jakubprzybytek/MobilePowerSupply/KiCad/MobilePowerBank/MobilePowerBank.kicad_pcb

## KiCad design KiCad/MobilePowerBank/MobilePowerBank.kicad_pcb (2019-04-13)

Schematic: MobilePowerBank.sch

Parts:
C1, C5, C11, C28, C45, C46, C71: 47u/35V; CP_Tantalum_Case-D_EIA-7343-31_Reflow
C2, C29, C30, C47, C48, C72: 10u/50V/X7R; C_2220
C3: 4n7; C_0805
C4, C33, C34, C51, C52, C73, C74: 22n; C_0805
C6, C7, C8, C13, C15, C16, C18, C20, C26, C39, C40, C41, C42, C57, C58, C59, C60, C63, C65, C67, C69, C77, C78: 100n; C_0805
C9, C10, C35, C36, C37, C38, C53, C54, C55, C56: 47u/1-45mESR; CP_Tantalum_Case-D_EIA-7343-31_Reflow
C12: 220n; C_0805
C14: 47u/16V; CP_Tantalum_Case-C_EIA-6032-28_Reflow
C17: 47u/6.3V; CP_Tantalum_Case-C_EIA-6032-28_Reflow
C19, C21, C64, C66, C68, C70: 10u/6.3V; CP_Tantalum_Case-B_EIA-3528-21_Reflow
C22, C23: 10u/16V; CP_Tantalum_Case-B_EIA-3528-21_Reflow
C24, C25, C27, C43, C44, C61, C62, C79: 1u; C_0805
C31, C32: 10n; C_0805
C49, C50: 4u7; C_0805
C75: 330n / 50V; C_0805
C76: 22u/16V; CP_Elec_4x5.8
C80, C82, C83, C84, C85, C86: 1u/50V; C_1206
C81: 100u/6V3; C_1812
D1: LED; D_0805
F1: 5A; Fuseholder5x20_horiz_open_inline_Type-I
J1: Power IN; TerminalBlock_Altech_AK300-2_P5.00mm
J2: Power OUT 2; TerminalBlock_Altech_AK300-2_P5.00mm
J3: Power OUT 1; TerminalBlock_Altech_AK300-2_P5.00mm
J4: OLED I2C; OLED_0.96inch_128x64_I2C
J5: PDI; Pin_Header_Straight_2x03_Pitch2.54mm
J6: OLED; FPC_30
J7: Power OUT 3; TerminalBlock_Altech_AK300-2_P5.00mm
J8: Power OUT 4; TerminalBlock_Altech_AK300-2_P5.00mm
J9: Power OUT 5; TerminalBlock_Altech_AK300-2_P5.00mm
J10: Power OUT 6; TerminalBlock_Altech_AK300-2_P5.00mm
J11: PowerLED; JST_XH_B02B-XH-A_02x2.50mm_Straight
L1: 10u; L_1206
MH1, MH2, MH3, MH4: MountingHole_Pad; MountingHole_3.5mm
R1, R6, R87: 68k; R_0805
R2, R9, R10, R21, R38, R39, R66, R67: 2k2; R_0805
R3, R14, R16, R17, R18, R19, R48, R49, R50, R51, R52, R53, R76, R77, R78, R79, R80, R81, R94, R95, R96: 0R033; R_2512
R4, R15, R20, R36, R37, R54, R55, R64, R65, R82, R83, R97: 20k; R_0805
R5, R12, R86: 100k; R_0805
R7, R27, R33, R35, R61, R63: 300k; R_0805
R8, R11, R23, R24, R47, R73, R75, R93: 10k; R_0805
R13, R28: 4k7; R_0805
R22, R29, R31, R44, R57, R59: 47k; R_0805
R25: 1M; R_1206
R26, R30, R56, R58: 220k; R_0805
R32, R34, R60, R62: 30k; R_0805
R40, R41, R42, R43, R68, R69, R70, R71: 15k4; R_0805
R45: 3k9; R_0805
R46, R72, R74, R92: 90k; R_0805
R84, R85, R98: 0; R_0805
R88: 11k; R_0805
R89: 1k5; R_0805
R90: 7k68; R_0805
R91: 200; R_0805
R99: 3k3; R_0805
SW1: SW_DIP_x01; Pin_Header_Angled_1x02_Pitch2.54mm
U1, U4, U9, U10, U13, U14, U16: INA139; SOT-23-5
U2, U7, U8: LMZ14203H; TO-263-7_TabPin4
U3: L78M12; TO-252-2_Rectifier
U5: UA78M33; TO-252-2_Rectifier
U6: LMZ14203; TO-263-7_TabPin4
U11, U12: LMZ14201H; TO-263-7_TabPin4
U15: ATXMEGA256A3U-AU; TQFP-64_14x14mm_Pitch0.8mm
U17: L78L05_SOT89; SOT-89-3
x1, x2, x3, x4, x6, x7, x8: jumper; Jumper_33x1.5
x5, x9: jumper; Jumper_45x1.5

Connections:
+3V3: C16.1, C17.1, C18.1, C19.1, C24.1, C63.1, C64.1, C65.1, C66.1, C67.1, C68.1, C69.1, C70.1, D1.2, J4.1, J5.2, J6.19, J6.20, J6.21, L1.1, R9.2, R10.2, R23.2, R24.1, U5.3 (OUT), U15.15 (VCC), U15.25 (VCC), U15.35 (VCC), U15.45 (VCC), U15.53 (VCC)
/+3.3VA: C20.1, C21.1, L1.2, U15.61 (AVCC)
/OLED_!DS: J6.17, U15.28 (RXD0/OC0C/PD2)
/OLED_!RES: J6.16, U15.31 (PD5/OC1B/XCK1/MOSI)
/OLED_D0: J6.12, U15.36 (PE0/OC0A/SDA/SDAIN)
/OLED_D1: J6.11, U15.37 (PE1/OC0B/XCK0/SCL/SCLIN)
/OLED_D2: J6.10, U15.38 (PE2/OC0C/RXD0/SDAOUT)
/OLED_D3: J6.9, U15.39 (PE3/OC0D/TXD0/SCLOUT)
/OLED_D4: J6.8, U15.40 (PE4/OC1A/~SS~)
/OLED_D5: J6.7, U15.41 (PE5/OC1B/XCK1/MOSI)
/OLED_D6: J6.6, U15.42 (PE6/RXD1/MISO/TOSC2)
/OLED_D7: J6.5, U15.43 (PE7/TXD1/SCK/TOSC1)
/OLED_D/!C: J6.15, U15.29 (TXD0/OC0D/PD3)
/OLED_E/!RD: J6.13, U15.30 (PD4/OC1A/~SS~)
/OLED_R/!W: J6.14, U15.32 (PD6/RXD1/D-/MISO)
GND: C5.2, C6.2, C12.2, C13.2, C14.2, C15.2, C16.2, C17.2, C18.2, C19.2, C20.2, C21.2, C22.2, C23.2, C24.2, C25.2, C26.2, C27.2, C39.2, C40.2, C43.2, C44.2, C57.2, C58.2, C61.2, C62.2, C63.2, C64.2, C65.2, C66.2, C67.2, C68.2, C69.2, C70.2, C77.2, C79.2, J4.2, J5.6, J6.1, J6.29, R25.1, R98.1, SW1.1, U3.2 (GND), U5.2 (GND), U15.14 (GND), U15.24 (GND), U15.34 (GND), U15.44 (GND), U15.52 (GND), U15.60 (GND)
GNDA: C1.2, C2.2, C3.2, C7.1, C8.1, C9.2, C10.2, C11.2, C28.2, C29.2, C30.2, C31.2, C32.2, C35.2, C36.2, C37.2, C38.2, C41.1, C42.1, C45.2, C46.2, C47.2, C48.2, C49.2, C50.2, C53.2, C54.2, C55.2, C56.2, C59.1, C60.1, C71.2, C72.2, C73.2, C75.2, C76.2, C78.1, C80.2, C81.2, C82.2, C83.1, C84.2, C85.2, C86.2, J1.1, J2.2, J3.2, J7.2, J8.2, J9.2, J10.2, J11.2, R2.2, R4.2, R13.2, R15.2, R20.2, R21.2, R36.2, R37.2, R38.2, R39.2, R45.2, R47.2, R54.2, R55.2, R64.2, R65.2, R66.2, R67.2, R73.2, R75.2, R82.2, R83.2, R88.2, R89.2, R93.2, R97.2, R98.2, U1.2, U2.4, U4.2, U6.4, U7.4, U8.4, U9.2, U10.2, U11.4, U12.4, U13.2, U14.2, U16.2, x6.1 (A), x6.2 (B), x7.1 (A), x7.2 (B), x8.1 (A), x8.2 (B), x9.1 (A), x9.2 (B)
IN_Current: C25.1, R4.1, U1.1, U15.11 (TDI/AC5/ADC5/PB5)
IN_Voltage: C15.1, R1.2, R2.1, U15.12 (TCK/AC1OUT/AC6/ADC6/PB6)
LED: R8.1, U15.48 (PF2/OC0C/RXD0)
unnamed: C3.1, U2.5
unnamed: C4.2, R21.1, R22.1, U2.6
unnamed: C5.1, C6.1, U3.1 (IN), x5.2 (B)
unnamed: C4.1, C8.2, C9.1, C10.1, C83.2, R14.2, R18.2, R19.2, R28.2, U2.7, U4.3, U4.5
unnamed: C23.1, J6.3
unnamed: C31.1, U7.5
unnamed: C32.1, U8.5
unnamed: C33.1, C35.1, C37.1, C41.2, C84.1, R42.2, R48.2, R49.2, R50.2, U7.7, U9.3, U9.5
unnamed: C33.2, R38.1, R40.1, U7.6
unnamed: C34.1, C36.1, C38.1, C42.2, C82.1, R43.2, R51.2, R52.2, R53.2, U8.7, U10.3, U10.5
unnamed: C34.2, R39.1, R41.1, U8.6
unnamed: C49.1, U11.5
unnamed: C50.1, U12.5
unnamed: C51.1, C53.1, C55.1, C59.2, C85.1, R70.2, R76.2, R77.2, R78.2, U11.7, U13.3, U13.5
unnamed: C51.2, R66.1, R68.1, U11.6
unnamed: C52.1, C54.1, C56.1, C60.2, C86.1, R71.2, R79.2, R80.2, R81.2, U12.7, U14.3, U14.5
unnamed: C52.2, R67.1, R69.1, U12.6
unnamed: C73.1, U6.5
unnamed: C74.1, C78.2, C80.1, C81.1, R91.2, R94.2, R95.2, R96.2, U6.7, U16.3, U16.5
unnamed: C74.2, R89.1, R90.1, U6.6
unnamed: C76.1, J11.1, R99.1, U17.2 (GND)
unnamed: D1.1, R8.2
unnamed: J6.4, R25.2
unnamed: R5.2, U2.2
unnamed: R6.2, R7.1
unnamed: R11.2, R23.1, SW1.2
unnamed: R7.2, R20.1, U2.3
unnamed: R22.2, R28.1
unnamed: R26.2, R32.1
unnamed: R5.1, R27.2
unnamed: R29.2, R33.1
unnamed: R30.2, R34.1
unnamed: R31.2, R35.1
unnamed: R32.2, U7.2
unnamed: R33.2, R36.1, U7.3
unnamed: R34.2, U8.2
unnamed: R35.2, R37.1, U8.3
unnamed: R40.2, R42.1
unnamed: R41.2, R43.1
unnamed: R56.2, R60.1
unnamed: R57.2, R61.1
unnamed: R58.2, R62.1
unnamed: R59.2, R63.1
unnamed: R60.2, U11.2
unnamed: R61.2, R64.1, U11.3
unnamed: R62.2, U12.2
unnamed: R63.2, R65.1, U12.3
unnamed: R68.2, R70.1
unnamed: R69.2, R71.1
unnamed: R84.2, R86.1
unnamed: R85.2, R87.1
unnamed: R86.2, U6.2
unnamed: R87.2, R88.1, U6.3
unnamed: R90.2, R91.1
unnamed: R99.2, U17.1 (OUT)
OUT_1_Current: C27.1, R15.1, U4.1, U15.3 (AC5/ADC5/PA5)
OUT_1_Voltage: C26.1, R12.2, R13.1, U15.4 (AC1OUT/AC6/ADC6/PA6)
OUT_2_Current: C43.1, R54.1, U9.1, U15.1 (AC3/ADC3/PA3)
OUT_2_Voltage: C39.1, R44.2, R45.1, U15.2 (AC4/ADC4/PA4)
OUT_3_Current: C44.1, R55.1, U10.1, U15.63 (AC1/ADC1/PA1)
OUT_3_Voltage: C40.1, R46.2, R47.1, U15.64 (AC2/ADC2/PA2)
OUT_4_Current: C61.1, R82.1, U13.1, U15.7 (AC1/ADC1/PB1)
OUT_4_Voltage: C57.1, R72.2, R73.1, U15.8 (DAC0/AC2/ADC2/PB2)
OUT_5_Current: C62.1, R83.1, U14.1, U15.5 (AC0OUT/AC7/ADC7/PA7)
OUT_5_Voltage: C58.1, R74.2, R75.1, U15.6 (AREFB/AC0/ADC0/PB0)
OUT_6_Current: C79.1, R97.1, U15.9 (DAC1/AC3/ADC3/PB3), U16.1
OUT_6_Voltage: C77.1, R92.2, R93.1, U15.10 (TMS/AC4/ADC4/PB4)
PDI_CLK: J5.5, R24.2, U15.57 (~RESET~/PDI_CLK)
PDI_DATA: J5.1, U15.56 (PDI_DATA)
POWER_1_OUT: J3.1, R12.1, R14.1, R18.1, R19.1, U4.4
POWER_2_OUT: J2.1, R44.1, R48.1, R49.1, R50.1, U9.4
POWER_3_OUT: J7.1, R46.1, R51.1, R52.1, R53.1, U10.4
POWER_4_OUT: J8.1, R72.1, R76.1, R77.1, R78.1, U13.4
POWER_5_OUT: J9.1, R74.1, R79.1, R80.1, R81.1, U14.4
POWER_6_OUT: J10.1, R92.1, R94.1, R95.1, R96.1, U16.4
POWER_IN: C11.1, C29.1, R3.1, R16.1, R17.1, R26.1, R29.1, U1.4, U7.1, x1.1 (A), x2.1 (A)
POWER_IN_1: C1.1, C2.1, R6.1, R27.1, U2.1, x2.2 (B), x3.1 (A)
POWER_IN_3: C28.1, C30.1, R30.1, R31.1, U8.1, x1.2 (B)
POWER_IN_4: C45.1, C46.1, C47.1, C48.1, R56.1, R57.1, R58.1, R59.1, U11.1, U12.1, x3.2 (B), x4.1 (A)
POWER_IN_6: C71.1, C72.1, R84.1, R85.1, U6.1, x4.2 (B), x5.1 (A)
SCK: J4.3, R9.1, U15.17 (SCLIN/SCL/XCK0/OC0AHS/OC0B/PC1)
SDA: J4.4, R10.1, U15.16 (SDAIN/SDA/~OC0ALS~/OC0A/PC0)
SWITCH: C12.1, R11.1, U15.49 (PF3/OC0D/TXD0)
Unfused_Power: C75.1, F1.1, J1.2, U17.3 (IN)
VDD: C7.2, F1.2, R1.1, R3.2, R16.2, R17.2, U1.3, U1.5

Notes on the sheet:
Dell Vout = 19.6V Iout(max) = 3A Uen = 22.9V SS 1 (Soft start order)
ASI1600 Vout = 12V Iout(max) = 3A SS 2
EQ6-R Vout = 12V Iout(max) = 3A SS 2
Moonlite Vout = 12V Iout(max) = 1A SS 1
FlatField Vout = 12V Iout(max) = 1A SS 1
USB Vout = 5V Iout(max) = 3A ss 3
R=5V/5mA=1k
3.9/(47+3.9) * 12V = 0.92V
4.7/(100+4.7) * 12V = 0.90V
2k2/(2k2+68k)=0.03 (1/32)

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
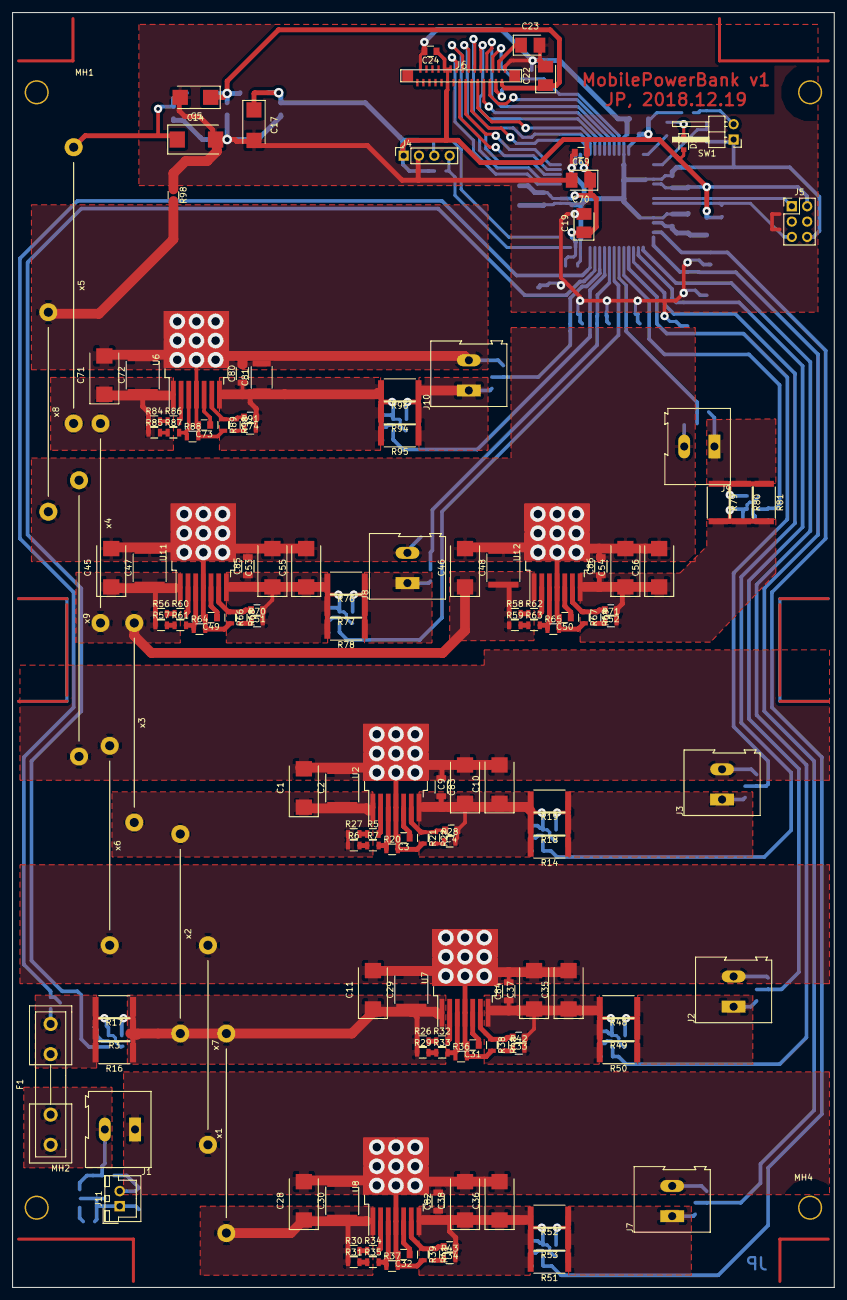
[picture p1: board MobilePowerBank.kicad_pcb from above]

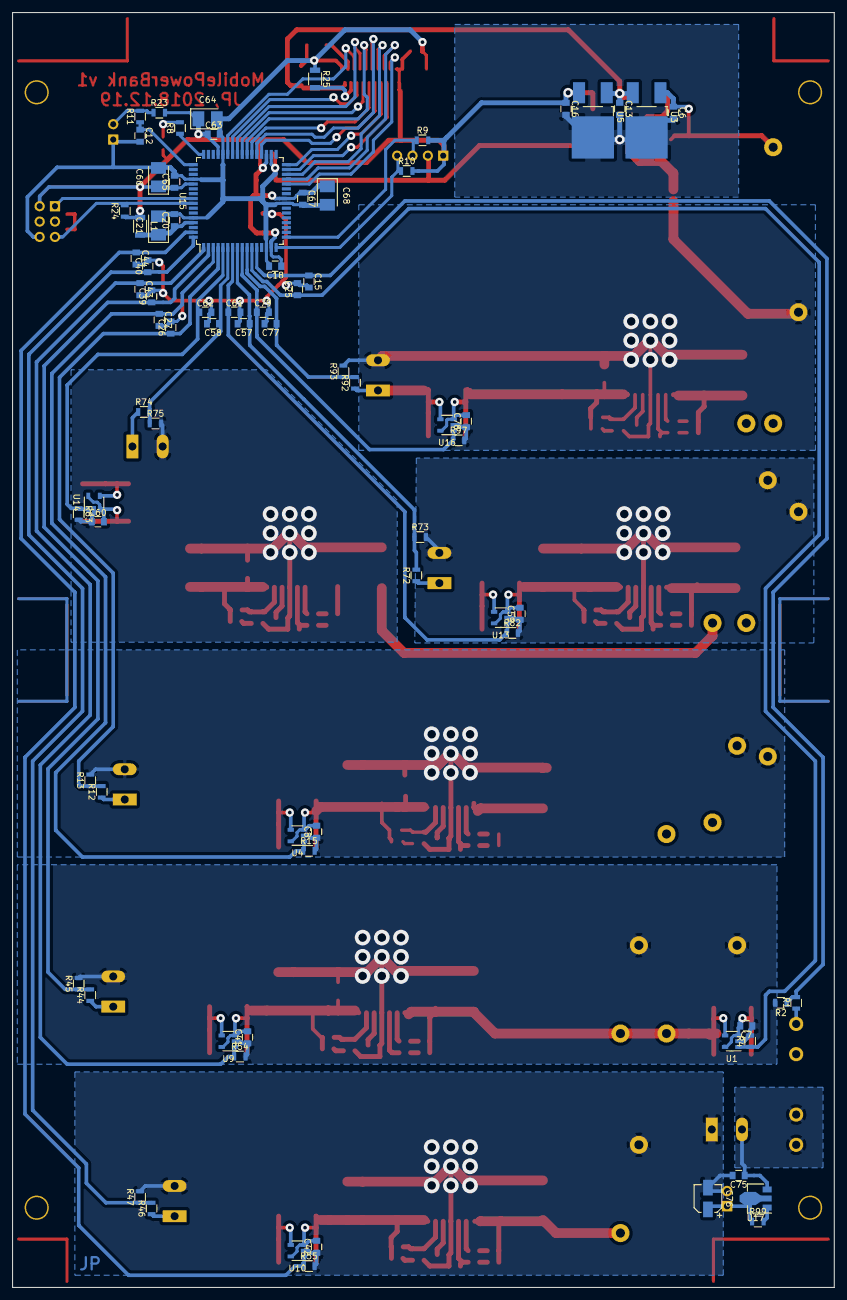
[picture p2: board MobilePowerBank.kicad_pcb from below]

Board: 2 copper layers, 136.0 x 211.0 mm, 230 parts (77 on the bottom side), 106 nets.
