jakubprzybytek/MobilePowerSupply/KiCad/Power Supply LMZ14203H/Power Supply LMZ14203H.kicad_pcb

## KiCad design KiCad/Power Supply LMZ14203H/Power Supply LMZ14203H.kicad_pcb (2018-09-23)

Schematic: Power Supply LMZ14203H.sch

Parts:
C1, C5, C14: 100u; CP_Elec_6.3x7.7
C2: 10u/35V/X7R; C_2220
C3: 4u7; C_0805
C4: 22n; C_0805
C6, C7, C8, C13, C15, C16, C18, C20, C26: 100n; C_0805
C9, C10: 47u/1-45mESR; CP_Tantalum_Case-D_EIA-7343-31_Reflow
C12: 10n; C_0805
C17: 47u; CP_Elec_6.3x5.8
C19, C21, C22, C23: 10u; CP_Elec_4x5.8
C24, C25, C27: 1u; C_0805
D1: LED; D_0805
F1: 5A; Fuseholder5x20_horiz_open_inline_Type-I
J1: Power IN; TerminalBlock_Altech_AK300-2_P5.00mm
J3: Power OUT; TerminalBlock_Altech_AK300-2_P5.00mm
J4: OLED I2C; OLED_0.96inch_128x64_I2C
J5: PDI; Pin_Header_Straight_2x03_Pitch2.54mm
J6: OLED; FPC_30
L1: 10u; L_1206
R1: 68k; R_0805
R2, R9, R10, R21: 2k2; R_0805
R3, R14, R16, R17, R18, R19: 0R1; R_2512
R4, R15, R20: 20k; R_0805
R5, R6: 30k; R_0805
R7: 300k; R_0805
R8, R11, R13, R23, R24: 10k; R_0805
R12: 90k; R_0805
R22, R28: 15k4; R_0805
R25: 1M; R_1206
R26: 0; R_0805
R27: 220k; R_0805
SW1: SW_DIP_x01; SW_SPST_B3S-1000
U1, U4: INA169; SOT-23-5
U2: LMZ14203H; TO-263-7_TabPin4
U3: L78M12; TO-252-2_Rectifier
U5: UA78M33; TO-252-2_Rectifier
U6: ATXMEGA32E5-AU; TQFP-32_7x7mm_Pitch0.8mm

Connections:
+3V3: C16.1, C17.1, C18.1, C19.1, C24.1, D1.2, J4.1, J5.2, J6.19, J6.20, J6.21, L1.1, R9.2, R10.2, R23.2, R24.1, U5.3, U6.17 (VCC)
+12V: C13.1, C14.1, C22.1, J6.2, U3.3, U5.1
/+3.3VA: C20.1, C21.1, L1.2, U6.32 (AVCC)
/OLED_!DS: J6.17, U6.21 (PD7/ADC15/TXD0/IN3/CLKOUT/EVOUT/AC0OUT)
/OLED_!RES: J6.16, U6.22 (PD6/ADC14/RXD0/IN0/RTCOUT/AC1OUT)
/OLED_D0: J6.12, U6.9 (AC0OUT/IN3/MOSI/TXD0/OC4DHS/OC4D/PC7)
/OLED_D1: J6.11, U6.10 (AC1OUT/IN0/MISO/RXD0/~OC4DLS~/OC4C/PC6)
/OLED_D2: J6.10, U6.11 (IN2/SCK/XCK0/OC5B/OC4CHS/OC4B/PC5)
/OLED_D3: J6.9, U6.12 (EXTCLK/OUT0/IN1/~SS~/OC5A/~OC4CLS~/OC4A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)
/OLED_D4: J6.8, U6.13 (IN3/TXD0/OC4BHS/OC4D/PC3)
/OLED_D5: J6.7, U6.14 (IN0/RXD0/~OC4BLS~/OC4C/PC2)
/OLED_D6: J6.6, U6.15 (IN2/SCL/XCK0/OC4AHS/OC4B/PC1)
/OLED_D7: J6.5, U6.16 (OUT0/IN1/SDA/~OC4ALS~/OC4A/PC0)
/OLED_D/!C: J6.15, U6.23 (PD5/ADC13/OC5B/XCK0/IN2)
/OLED_E/!RD: J6.13, U6.25 (PD3/ADC11/TXD0/IN3/OC1)
/OLED_R/!W: J6.14, U6.24 (PD4/ADC12/OC5A/IN1/OUT0/CLKOUT/EVOUT)
GND: C5.2, C6.2, C7.1, C8.1, C12.2, C13.2, C14.2, C15.2, C16.2, C17.2, C18.2, C19.2, C20.2, C21.2, C22.2, C23.2, C24.2, C25.2, C26.2, C27.2, J4.2, J5.6, J6.1, J6.29, R2.2, R4.2, R13.2, R15.2, R25.1, R26.1, SW1.1, U1.2, U3.2, U4.2, U5.2, U6.1 (GND), U6.18 (GND)
GNDA: C1.2, C2.2, C3.2, C9.2, C10.2, J1.1, J3.2, R20.2, R21.2, R26.2, U2.4
IN_Current: C25.1, R4.1, U1.1, U6.3 (DAC1/AC3/ADC3/PA3)
IN_Voltage: C15.1, R1.2, R2.1, U6.4 (DAC0/AC2/ADC2/PA2)
LED: R8.1, U6.30 (AC1OUT/AC6/ADC6/PA6)
unnamed: C1.1, C2.1, R3.1, R6.1, R16.1, R17.1, R27.1, U1.4, U2.1
unnamed: C3.1, U2.5
unnamed: C4.2, R21.1, R22.1, U2.6
unnamed: C4.1, C8.2, C9.1, C10.1, R12.1, R14.2, R18.2, R19.2, R28.2, U2.7, U4.3, U4.5
unnamed: C23.1, J6.3
unnamed: D1.1, R8.2
unnamed: F1.1, J1.2
unnamed: J6.4, R25.2
unnamed: R5.2, U2.2
unnamed: R6.2, R7.1
unnamed: R11.2, R23.1, SW1.2
unnamed: R7.2, R20.1, U2.3
unnamed: R22.2, R28.1
unnamed: R5.1, R27.2
OUT_Current: C27.1, R15.1, U4.1, U6.6 (AREF/AC0/ADC0/PA0)
OUT_Voltage: C26.1, R12.2, R13.1, U6.5 (AC1/ADC1/PA1)
PDI_CLK: J5.5, R24.2, U6.8 (~RESET~/PDI_CLK)
PDI_DATA: J5.1, U6.7 (PDI_DATA)
POWER_IN: C5.1, C6.1, C7.2, F1.2, R1.1, R3.2, R16.2, R17.2, U1.3, U1.5, U3.1
POWER_OUT: J3.1, R14.1, R18.1, R19.1, U4.4
SCK: J4.3, R9.1, U6.27 (PD1/ADC1/XCK0/SCL/IN2)
SDA: J4.4, R10.1, U6.28 (PD0/ADC8/SDA/IN1/OUT0/AREF)
SWITCH: C12.1, R11.1, U6.29 (AC0OUT/AC7/ADC7/PA7)

Notes on the sheet:
Vout = 12V Iout(max) = 3A
Enable range 1.18-6.50V Rup/Rdown = (Uin/1.18)-1

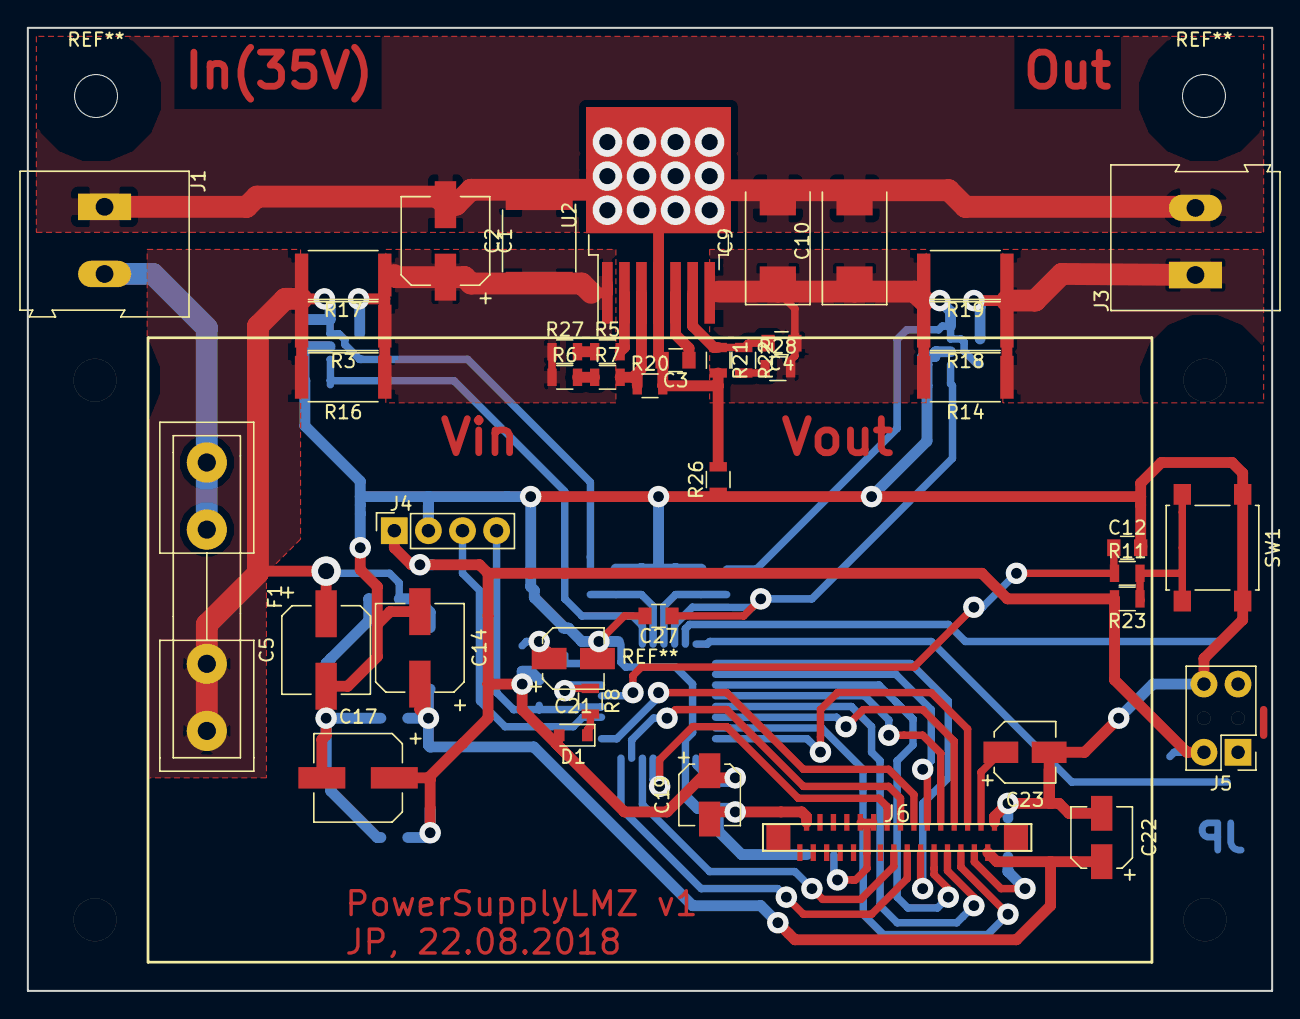
[picture p3: board Power Supply LMZ14203H.kicad_pcb from above]

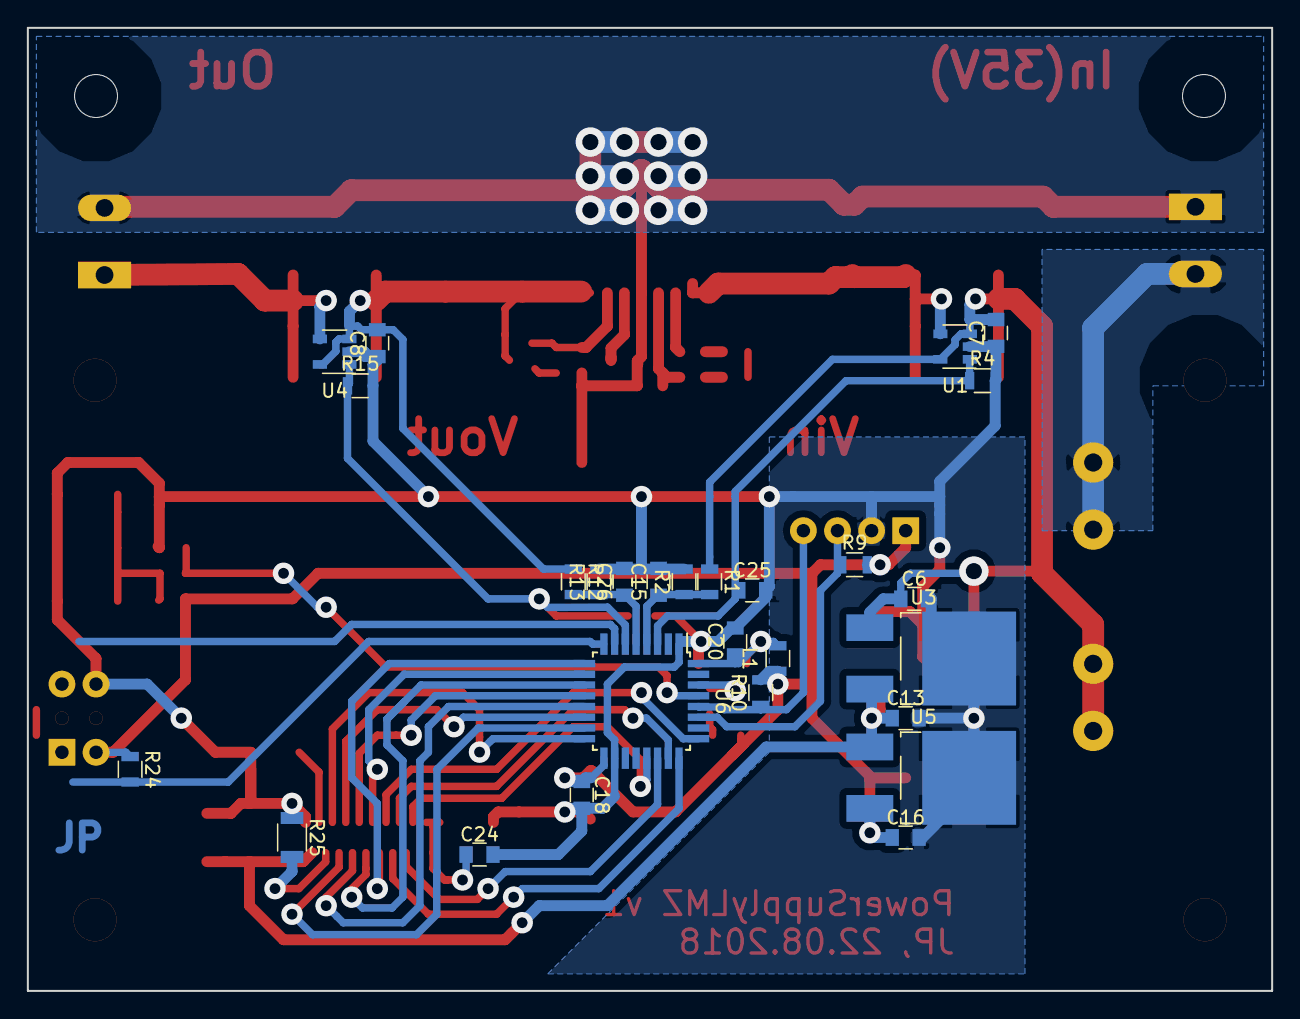
[picture p4: board Power Supply LMZ14203H.kicad_pcb from below]

Board: 2 copper layers, 92.7 x 71.8 mm, 69 parts (27 on the bottom side), 44 nets.
