jakubprzybytek/MobilePowerSupply/KiCad/Power Supply LM2576/Power Supply LM2576.kicad_pcb

## KiCad design KiCad/Power Supply LM2576/Power Supply LM2576.kicad_pcb (2017-12-07)

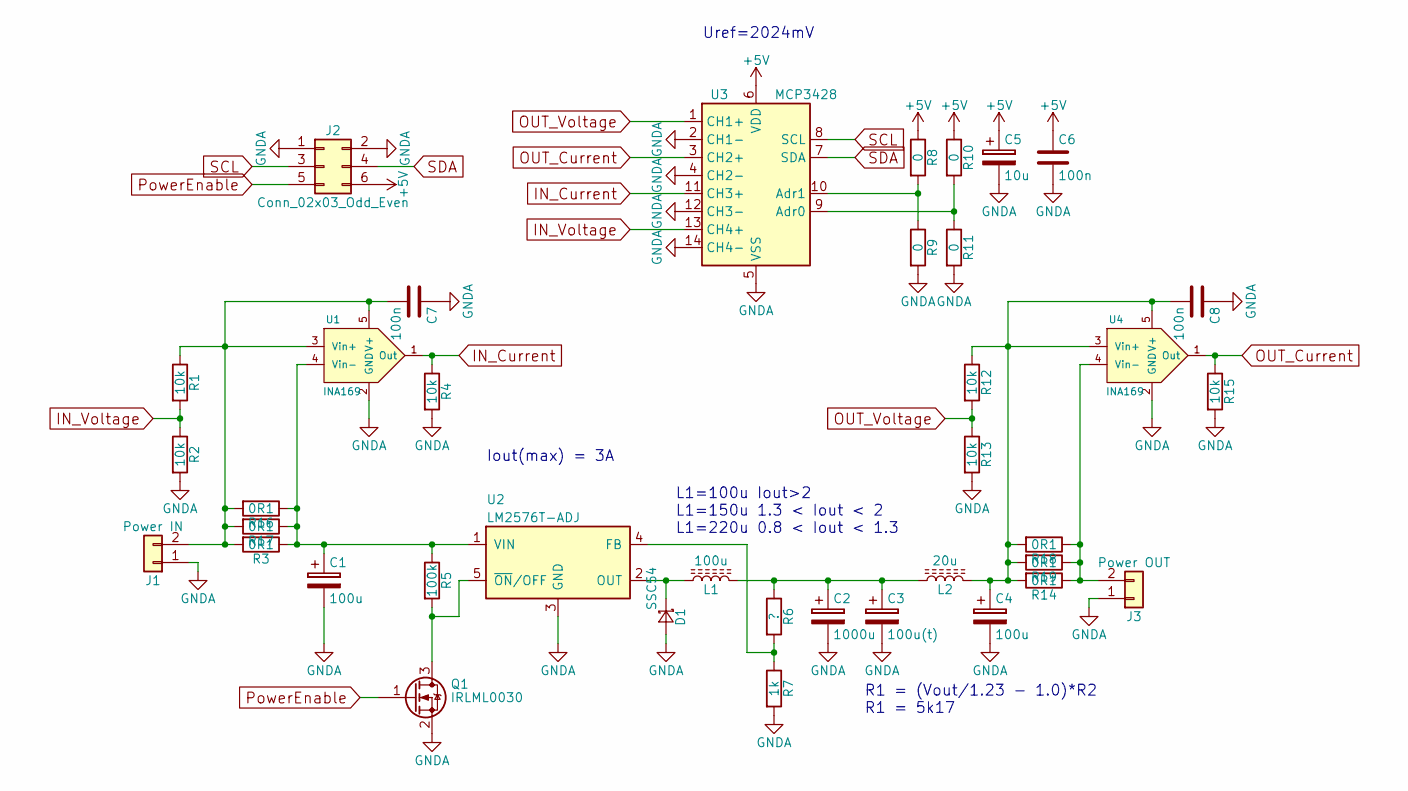
[picture p5: schematic Power Supply LM2576.sch]

Parts:
C1: 100u; CP_Radial_D8.0mm_P2.50mm
C2: 1000u; CP_Radial_D10.0mm_P2.50mm
C3: 100u(t); CP_Tantalum_Case-D_EIA-7343-31_Reflow
C4: 100u; CP_Radial_D6.3mm_P2.50mm
C5: 10u; CP_Radial_D6.3mm_P2.50mm
C6, C7, C8: 100n; C_0805
D1: SSC54; D_SMC
J1: Power IN; Pin_Header_Straight_1x02_Pitch2.54mm
J2: Conn_02x03_Odd_Even; Pin_Header_Straight_2x03_Pitch2.54mm
J3: Power OUT; Pin_Header_Straight_1x02_Pitch2.54mm
L1: 100u; L_Toroid_Vertical_L26.7mm_W14.0mm_P10.16mm_Pulse_D
L2: 20u; L_Toroid_Vertical_L16.8mm_W9.2mm_P7.10mm_Vishay_TJ3
Q1: IRLML0030; SOT-23
R1, R2, R4, R12, R13, R15: 10k; R_0805
R3, R14, R16, R17, R18, R19: 0R1; R_2512
R5: 100k; R_0805
R6: ?; R_0805
R7: 1k; R_0805
R8, R9, R10, R11: 0; R_0805
U1, U4: INA169; SOT-23-5
U2: LM2576T-ADJ; TO-220-5_Vertical_StaggeredType1
U3: MCP3428; SOIC-14_3.9x8.7mm_Pitch1.27mm

Connections:
+5V: C5.1, C6.1, J2.6, R8.1, R10.1, U3.6 (VDD)
GNDA: C1.2, C2.2, C3.2, C4.2, C5.2, C6.2, C7.1, C8.1, D1.2 (A), J1.1, J2.1, J2.2, J3.1, Q1.2 (S), R2.2, R4.2, R7.2, R9.2, R11.2, R13.2, R15.2, U1.2 (GND), U2.3 (GND), U3.2 (CH1-), U3.4 (CH2-), U3.5 (VSS), U3.12 (CH3-), U3.14 (CH4-), U4.2 (GND)
IN_Current: R4.1, U1.1 (Out), U3.11 (CH3+)
IN_Voltage: R1.2, R2.1, U3.13 (CH4+)
unnamed: C1.1, R3.1, R5.1, R16.1, R17.1, U1.4 (Vin-), U2.1 (VIN)
unnamed: C2.1, C3.1, L1.2, L2.1, R6.1
unnamed: C4.1, C8.2, L2.2, R12.1, R14.2, R18.2, R19.2, U4.3 (Vin+), U4.5 (V+)
unnamed: C7.2, J1.2, R1.1, R3.2, R16.2, R17.2, U1.3 (Vin+), U1.5 (V+)
unnamed: D1.1 (K), L1.1, U2.2 (OUT)
unnamed: J3.2, R14.1, R18.1, R19.1, U4.4 (Vin-)
unnamed: Q1.3 (D), R5.2, U2.5 (~ON~/OFF)
unnamed: R6.2, R7.1, U2.4 (FB)
unnamed: R8.2, R9.1, U3.10 (Adr1)
unnamed: R10.2, R11.1, U3.9 (Adr0)
OUT_Current: R15.1, U3.3 (CH2+), U4.1 (Out)
OUT_Voltage: R12.2, R13.1, U3.1 (CH1+)
PowerEnable: J2.5, Q1.1 (G)
SCL: J2.3, U3.8 (SCL)
SDA: J2.4, U3.7 (SDA)

Notes on the sheet:
R1 = (Vout/1.23 - 1.0)*R2 R1 = 5k17
L1=100u Iout>2 L1=150u 1.3 < Iout < 2 L1=220u 0.8 < Iout < 1.3
Iout(max) = 3A
Uref=2024mV

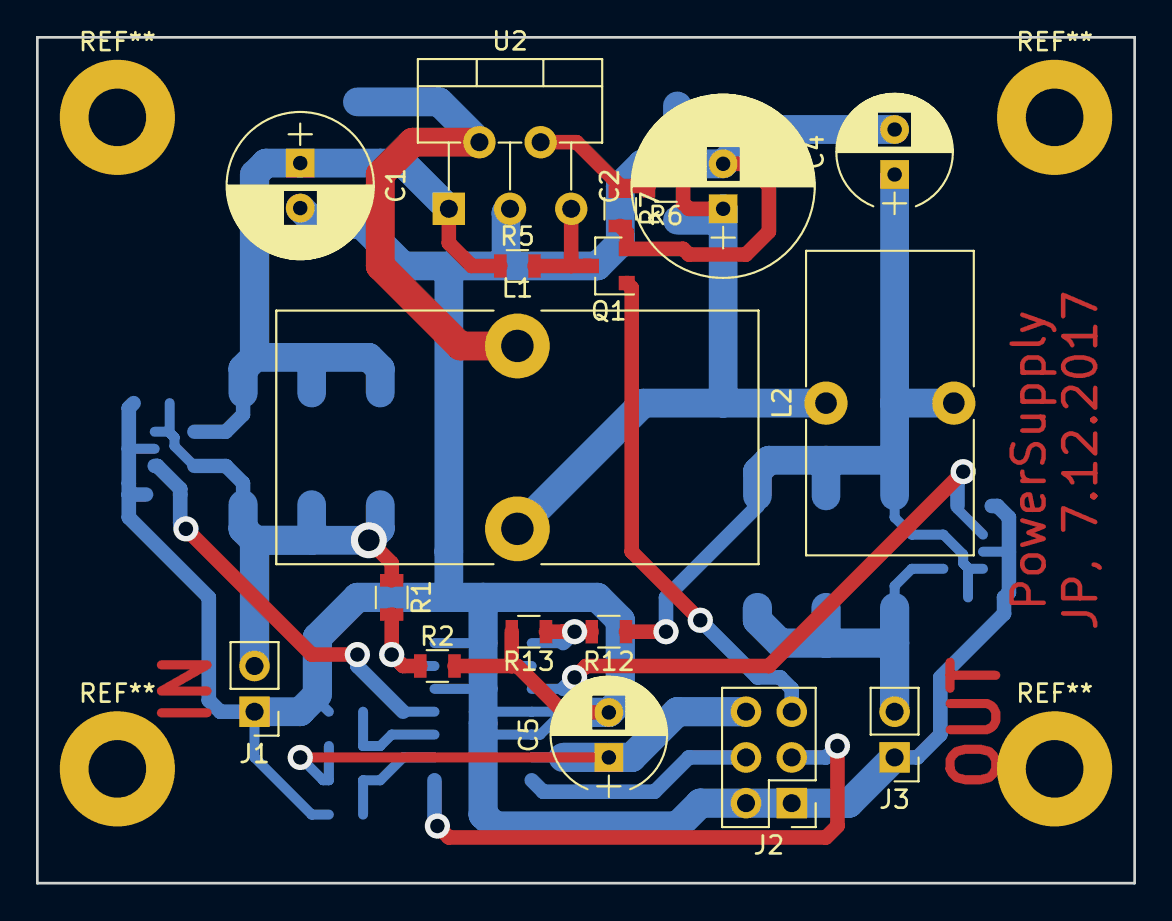
[picture p6: board Power Supply LM2576.kicad_pcb from above]

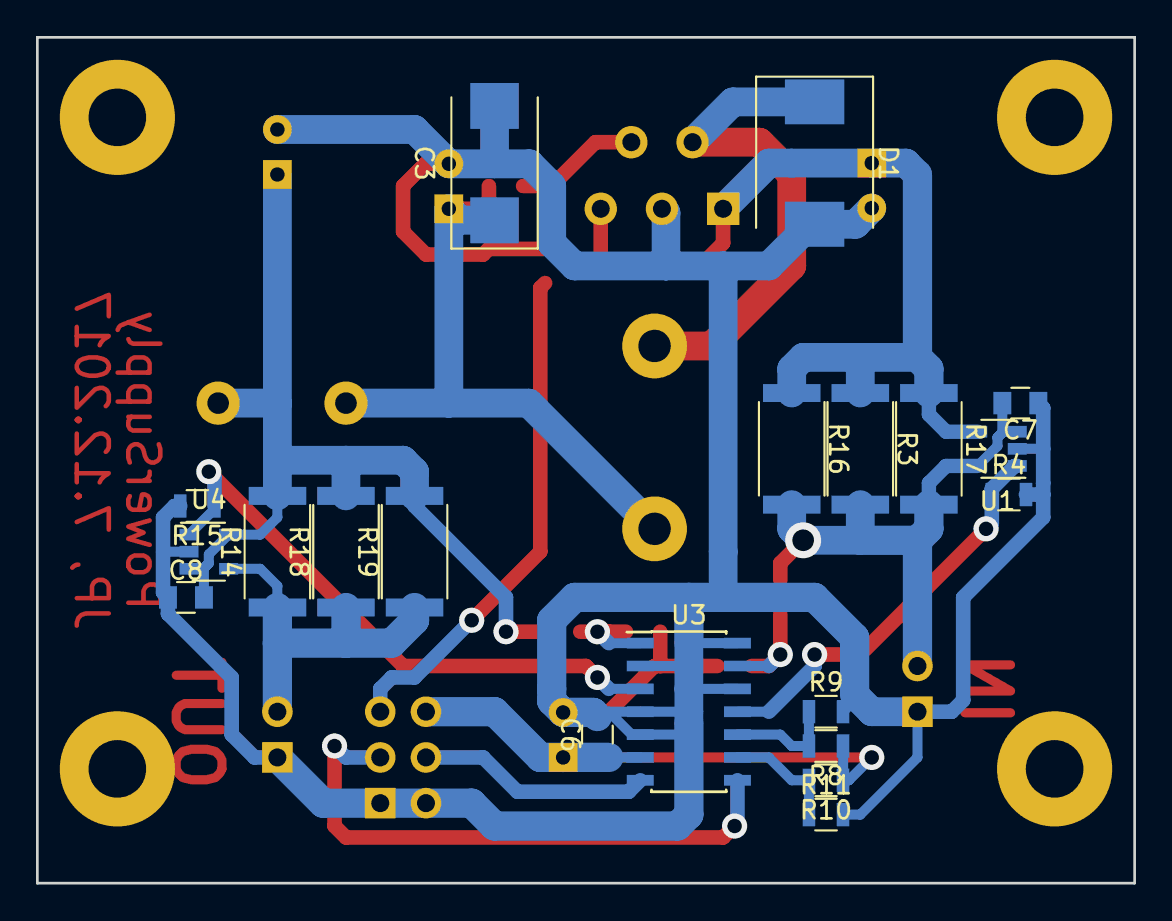
[picture p7: board Power Supply LM2576.kicad_pcb from below]

Board: 2 copper layers, 61.0 x 47.0 mm, 38 parts (20 on the bottom side), 19 nets.
