jakubprzybytek/MobilePowerSupply/AtmelStudio/MobilePowerBank/MobilePowerBank.cpp

/*
 * MobilePowerBank.cpp
 *
 * Created: 2019-01-05 21:44:43
 * Author : Rodos
 */ 

#include <avr/io.h>
#include <avr/interrupt.h>
#include <util/delay.h>

#include <stdio.h>
#include <string.h>

#include "MobilePowerBank.h"

#include "Screen.hpp"
#include "Events.h"

#include "Devices/TC74.h"

#include "IO/GUI.h"
#include "IO/Metter.h"
#include "IO/SerialCom.h"

#include "Peripheral/RTC.hpp"
#include "Peripheral/AC.hpp"

#include "Tools/Timer.hpp"
#include "Tools/Switch.hpp"
#include "Tools/StatsMemory.hpp"
#include "Tools/NamesMemory.h"

Events events;
Clock clock;

char names[6][5] = { "In  ", "Out1", "Out2", "Out3", "Out4", "Out5" };

SerialCom serialCom;
Screen screen;

Metter metter;
TC74 termometer;

StatsMemory statsMemory;
NamesMemory namesMemory;

uint32_t ampsConsumed; // per second
uint8_t temp;
uint8_t secondsToReset;

char serialComBuffer[100];

/* *****************
 * RTC: 1 sec INT (Low)
 ***************** */
ISR (RTC_OVF_vect) {
	events.submit(RTC_SECOND_PASSED);
}

/* *****************
 * TCC0: Display refresh timer interrupt (Low)
 ***************** */
ISR (TCC0_OVF_vect) {
	events.submit(REFRESH_DISPLAY);
}

/* *****************
 * TCD0: Button check timer interrupt (Low)
 ***************** */
ISR (TCD0_OVF_vect) {
	events.submit(BUTTON_CHECK);
}

/* *****************
 * Port F: Switch 0 int (Low)
 ***************** */
ISR (PORTF_INT0_vect) {
	events.submit(BUTTON_PRESSED);
}

/* *****************
 * USART C1: Received data (Low)
 ***************** */
ISR (USARTC1_RXC_vect) {
	uint8_t data = USARTC1.DATA;
	if (serialCom.processReceivedData(data)) {
		events.submit(USART_MESSAGE_RECEIVED);
	}
}

/* *****************
 * DMA CH0: DMA transaction finished interrupt (Medium)
 ***************** */
ISR (DMA_CH0_vect) {
	metter.stopA();
	events.submit(ADC_DMA_A_FINISHED);
	DMA.INTFLAGS = DMA_CH0TRNIF_bm;
}

/* *****************
 * DMA CH1: DMA transaction finished interrupt (Medium)
 ***************** */
ISR (DMA_CH1_vect) {
	metter.stopB();
	events.submit(ADC_DMA_B_FINISHED);
	DMA.INTFLAGS = DMA_CH1TRNIF_bm;
}

/* *****************
 * DMA CH2: DMA transaction finished interrupt (Medium)
 ***************** */
ISR (DMA_CH2_vect) {
	// TODO: disabe INT
	DMA.INTFLAGS = DMA_CH2TRNIF_bm;
}

/* *****************
 * ACB: Falling edge detected in input voltage (High)
***************** */
ISR (ACB_AC0_vect) {
	screen.shutdown();
	LED_SET
	statsMemory.storeData(clock, &ampsConsumed);
}

void drawStatusBar(bool firstDraw) {
	
	if (secondsToReset > 0 && secondsToReset <= 5) {
		screen.drawSecondsToReset(secondsToReset);
		return;
	}

	if ((clock.seconds % 10 == 0)) { // every ten seconds
		temp = termometer.readTemperature();
		screen.drawTemperature(temp);
	}
	if ((clock.seconds + 5) % 10 == 0 || firstDraw) {
		screen.drawAmpsConsumed(ampsConsumed);
	}

	screen.drawTime(clock.days, clock.hours, clock.minutes, clock.seconds);
}

void resetStatus() {
	clock.reset();
	ampsConsumed = 0;
}

int main(void)
{
	InterruptSwitch button(&PORTF, PIN3_bm, &(PORTF.PIN3CTRL));

	Timer displayTimer(&TCC0, 200);
	Timer buttonTimer(&TCD0, 50);

	AC inputPowerComparator(&ACB);

	uint16_t buttonCounter = 0;

	LED_INIT

	statsMemory.loadData(clock, &ampsConsumed);
	namesMemory.loadData(names);

	screen.init(names, true);
	metter.init();
	serialCom.init();
	clock.init();
	displayTimer.Init(TC_OVFINTLVL_LO_gc);
	buttonTimer.Init(TC_OVFINTLVL_MED_gc);
	button.init();
	termometer.init();
	inputPowerComparator.init();
	
	displayTimer.Enable();
	inputPowerComparator.start();

	clock.start();

	// enable interrupts
	PMIC.CTRL = PMIC_HILVLEN_bm | PMIC_MEDLVLEN_bm | PMIC_LOLVLEN_bm;
	sei();

	drawStatusBar(true);

    while (1) {
		Event event = events.get();

		if (event == ADC_DMA_A_FINISHED) {
			metter.storeReadoutA();
		} else

		if (event == ADC_DMA_B_FINISHED) {
			metter.storeReadoutB();
		} else

		if (event == RTC_SECOND_PASSED) {
			clock.countSecond();
			ampsConsumed += metter.measurements.inCurrentValue;

			if (screen.isActive()) {
				drawStatusBar(false);
			}
		} else

		if (event == REFRESH_DISPLAY) {
			LED_TOGGLE
			if (screen.isActive()) {
				screen.drawElectricParams(metter.measurements);
			}
			metter.toggleInput();
			metter.start();
		} else

		if (event == BUTTON_PRESSED) {
			buttonCounter = 0;
			buttonTimer.Enable();
		} else

		if (event == BUTTON_CHECK) { // event triggered 39 times per second as long as the button is pressed
			LED_TOGGLE

			if (button.isUp()) { // button is released
				buttonTimer.Disable();
			}
			
			if (screen.isActive()) {
				if (button.isUp()) { // button is released
					if (secondsToReset == 5) { // quick button press means to toggle screen
						screen.shutdown();
					} else {
						drawStatusBar(true);
					}

					secondsToReset = 0;

				} else { // button still pressed
					buttonCounter++;
					secondsToReset = 5 - MIN(buttonCounter/39, 5);

					if (secondsToReset == 0) {
						buttonTimer.Disable();

						resetStatus();
						drawStatusBar(true);
					}
				}
			} else {
				if (button.isUp()) { // releasing button when screen is disabled always just turns it on
					screen.init(names, false);
					drawStatusBar(true);
				}
			}
		} else

		if (event == USART_MESSAGE_RECEIVED) {
			char* command = serialCom.getReceivedData();
			switch (command[0]) {
			case 's':
				serialCom.sendData(names, metter.measurements, clock, ampsConsumed, temp);
				break;
			case 'r':
				resetStatus();
				serialCom.sendMessage("Clock and counters are reset!\n");
				break;
			case 'i':
				if (command[1] == ' ' && strlen(command) > 2 && strlen(command) <= 6) {

					char* newName = command + 2;
					strcpy(names[0], newName);
					namesMemory.storeData(names);
					
					screen.drawTemplate(names);
					
					sprintf(serialComBuffer, "New name for input: %s\n", newName);
					serialCom.sendMessage(serialComBuffer);
				}
				break;
			case 'o':
				if (strlen(command) > 3) {

					uint8_t inputIndex = command[1] - '0';
					if (inputIndex >= 1 && inputIndex <= 5) {

						if (command[2] == ' ' && strlen(command) <= 7) {

							char* newName = command + 3;
							strcpy(names[inputIndex], newName);
							namesMemory.storeData(names);

							screen.drawTemplate(names);

							sprintf(serialComBuffer, "New name for output %u: %s\n", inputIndex, newName);
							serialCom.sendMessage(serialComBuffer);
						}
					}
				}
				break;
			case 'd':
				sprintf(serialComBuffer, "Debug\n EEPROM writes: %u (stats), %u (names)\n Max waiting events: %u\n", statsMemory.eepromWrites, namesMemory.eepromWrites, events.maxEventsListIndex);
				serialCom.sendMessage(serialComBuffer);
				break;
			default:
				serialCom.sendHelp();
			}
		}
	}
}
