jakubprzybytek/MobilePowerSupply/AtmelStudio/MobilePowerBank/IO/GUI.h

/*
 * GUI.h
 *
 * Created: 2015-06-10 21:27:02
 *  Author: Rodos
 */ 


#ifndef GUI_H_
#define GUI_H_

#include <stdbool.h>

#define MAX_X 63

void GUI_Init();
void GUI_Shutdown();
bool GUI_IsActive();

void GUI_Clean();

void GUI_print3(char* text, unsigned char x, unsigned char y, unsigned char pattern);

#endif /* GUI_H_ */
