jakubprzybytek/MobilePowerSupply/(commit log)

2017-11-08 Folder added
    [Power Supply LM2576.kicad_pcb, Power Supply LM2576.sch]
2017-11-09 ADC added for monitoring
    [Power Supply LM2576.sch]
2017-11-18 PCB init
    [Power Supply LM2576.kicad_pcb, Power Supply LM2576.sch]
2017-12-01 Some work on PCB
    [Power Supply LM2576.kicad_pcb, Power Supply LM2576.sch]
2017-12-05 PCB work
    [Power Supply LM2576.kicad_pcb]
2017-12-07 Finishing PCB
    [Power Supply LM2576.kicad_pcb, Power Supply LM2576.sch]
2018-07-29 Changing folder structure
    [Power Supply LM2576.kicad_pcb, Power Supply LM2576.sch]
2018-08-11 LMZ14203H added
    [Power Supply LMZ14203H.kicad_pcb, Power Supply LMZ14203H.sch, _saved_Power Supply LMZ14203H.sch]
2018-08-14 CPU added
    [Power Supply LMZ14203H.sch, _saved_Power Supply LMZ14203H.sch]
2018-08-15 Wirering done
    [Power Supply LMZ14203H.kicad_pcb, Power Supply LMZ14203H.sch]
2018-08-20 PCB proofing
    [Power Supply LMZ14203H.kicad_pcb, _saved_Power Supply LMZ14203H.sch]
2018-08-23 Some fixes
    [Power Supply LMZ14203H.kicad_pcb]
2018-09-23 Software init commit
    [Power Supply LMZ14203H.kicad_pcb, Power Supply LMZ14203H.sch]
2018-09-23 PCb fixes
    [Power Supply LMZ14203H.kicad_pcb]
2018-10-04 Screen.cpp added, some clean up, too
    [Power Supply LMZ14203H.sch]
2018-10-07 MobilePowerBank init
    [MobilePowerBank.kicad_pcb, MobilePowerBank.sch]
2018-10-09 5 power supplies created
    [MobilePowerBank.kicad_pcb, MobilePowerBank.sch]
2018-10-11 xmega added
    [MobilePowerBank.kicad_pcb, MobilePowerBank.sch]
2018-10-11 Bigger case
    [MobilePowerBank.kicad_pcb]
2018-10-13 PCB major work
    [MobilePowerBank.kicad_pcb, MobilePowerBank.sch]
2018-10-15 PCB finish, BOM check
    [MobilePowerBank.kicad_pcb, MobilePowerBank.sch]
2018-10-24 Cap changed
    [MobilePowerBank.kicad_pcb, MobilePowerBank.sch]
2018-12-13 Aligning PCB
    [MobilePowerBank.kicad_pcb, MobilePowerBank.sch]
2018-12-14 Pimping PCB
    [MobilePowerBank.kicad_pcb, MobilePowerBank.sch]
2019-01-08 MobilePowerBank ADC first code
    [Power Supply LMZ14203H.sch, _saved_MobilePowerBank.sch]
2019-01-09 DMA added
2019-01-10 DMA and screen
    [MobilePowerBank.kicad_pcb, MobilePowerBank.sch, _saved_MobilePowerBank.sch]
2019-01-27 Support for Output 3 added
    [MobilePowerBank.sch]
2019-01-28 Added support for the switch
2019-01-30 Out 4 added
    [_saved_MobilePowerBank.sch]
2019-02-20 Five outputs callibration
    [MobilePowerBank.kicad_pcb, MobilePowerBank.sch, _saved_MobilePowerBank.sch]
2019-02-24 Temperature readout routine added
2019-02-24 Mounting holes fixed to 4mm
    [MobilePowerBank.kicad_pcb]
2019-03-02 Storing data in EEPROM on power loss
    [MobilePowerBank.sch]
2019-03-03 Reset button action implemented
2019-04-13 Serial port added
    [MobilePowerBank.kicad_pcb, MobilePowerBank.sch]
2019-04-13 DMA stuff refactored. Not tested.
2019-04-13 Using DMA for USAR transmition
2019-04-13 UART communication
